Vera-loves-program/acg720-vision-robot/docs/六题演示与修复验收_20261025.md

# 六题演示与本轮修复（客户端 v20）

> **当前核心版优先：** 为解决888条未布通，LCD设置/PID/候选选择/速度编辑等已删除，六题主干不变；具体按钮和编译结果以[核心版说明](核心版编译与视频可行性_20261025.md)为准。用户已授权代理运行高云，新构建记录在`tmp/core-route-20261025/`；下文“未运行高云”和24页UI均为上一轮状态。

这是当前源码的操作说明，优先于旧版 ARM、三秒倒计时、自动后退和 v18 手动重启说明。**代码、离线回归已更新；尚未运行 Gowin、生成新位流或验收实车。** 用户目前充电、Pi 已关机，本轮没有操作设备。

## 先更新一次

FPGA：仍打开原来的 `vision_robot_ui.gprj`，由用户编译本轮源码并下载。工程/约束/厂商 IP 没有在本轮修改；目录已有 fs 不代表包含这轮改动。保留 FPGA 摄像头→DDR→LCD。

Pi：充好电开机后，先网线连接电脑。电脑 PowerShell：

```powershell
scp "D:\GOWIN_PROJECTS\acg720_vision_robot\output\releases\acg720-orangepi-v20-code.zip" orangepi@192.168.10.3:/home/orangepi/
ssh orangepi@192.168.10.3
```

以下在 Pi 的 SSH 终端执行：

```sh
cd /home/orangepi/acg720_vision
cp -a config/gimbal.json config/gimbal.before-v20.json
unzip -o /home/orangepi/acg720-orangepi-v20-code.zip -d /home/orangepi
/home/orangepi/.venvs/acg720-detection/bin/python -c "import json; print(json.load(open('manifest.json'))['client_bundle_version'])"
sh tools/install_orangepi_poweroff.sh --install
sh tools/install_fpga_follow_service.sh
```

版本应为 **20**。本次代码包不包含现场 `gimbal.json`、`visual_task.json` 或模型，不重装 Python/OpenCV。安装脚本会结束旧的真实 `usb_gimbal.py` 进程，再安装视觉开机服务；启动服务本身不选目标、不转舵机、不启动轮子。以后不用每次开机运行 nohup。sudo 可能要求输入密码。

以后更新代码后的重启与检查统一使用：

```sh
cd /home/orangepi/acg720_vision
sh tools/start_fpga_follow.sh --restart
sh tools/start_fpga_follow.sh --status
```

电脑有线 `.4`，Pi `.3`，FPGA `.2`，掩码 `/24`。确认服务正常后，把网线从电脑换到 FPGA。换线产生短时 `Network is unreachable` 不再变成永久 PWM 错误。服务/相机正常与 FPGA 链路正常是两个条件；LCD 的 `PI LINK WAIT` 明确表示后者尚未建立，不能用“进程存在”代替链路验收。

## 六个入口

| 首页 | 操作 | 本轮行为 |
|---|---|---|
|1 CAMERA + IMU|直接进入|FPGA 摄像头画面与 IMU 显示保留；与 Pi USB 相机独立。|
|2 MOTOR CONTROL|FORWARD / REVERSE / TURN LEFT / TURN RIGHT / TURN 180 / STOP|点击方向直接执行，不需要 ARM。SPEED 调速度。|
|3 LIDAR AVOID|START / STOP / VIEW MAP / RADAR +90|沿车头低速走，前方近障减速/停车。地图可见。**此页演示减速/停车；路线绕行在题4/6。**|
|4 XY NAVIGATION|HERE IS ZERO → SET GOAL → GO TO GOAL|一键当前位置为原点、当前车头为 +X、左侧为 +Y；X/Y 单位 mm。LEFT/RIGHT 90 独立陀螺仪转向。|
|5 VISION TARGET|TRACK DOG / CHOOSE OBJECT / STOP TRACK|自动选择连续稳定的小狗，或按实时稳定 ID 选择其他候选，云台居中，车轮不走。|
|6 FIND DOG|FIND DOG / FACE DOG / GO NEAR DOG / SIDE FOLLOW / CAMERA FRONT / STOP|搜索、雷达定位、转向目标及带避障的接近；原左侧前后跟随放在 SIDE FOLLOW。|

SETTINGS 是统一调试入口。ALL STOP 随时停止动作；无需另点 ARM。保留真实电机故障、传感器断流、近障停车及已确认舵机限位。导航错误后不会自动倒车，也不会在解除故障后自行续跑。

### 题4：坐标、90°和指定点

静止等陀螺仪校准完成。将车头朝你希望的 +X，按 **HERE IS ZERO**。实现先停止控制链，随后同时清 X/Y/航向和旧地图，不会只改屏幕数字。默认目标为 `(300,0)`。SET GOAL 只有 X−/X+/Y−/Y+/STEP/DONE；先验证 `(300,0)`，再 `(300,300)` 等点。

LEFT 90 应原地左转约90°，RIGHT 90 相反；使用实测 Z 轴角速度积分后的航向与零偏修正。固定角度转向不经过旧自动后退恢复，也不依赖轮子位置环。陀螺仪不是绝对罗盘，长时间漂移仍需静止重置；不能声称是完整 SLAM。

GOTO 在车体坐标控制前进、用航向外环旋转；遇阻时在**已知空闲**栅格内做车体膨胀后的路径规划，未扫描区不能冒充可通行。`START UNKNOWN` 表示起点周围没有足够扫描覆盖，`GOAL UNKNOWN` 表示目标附近覆盖不足；`START/GOAL BLOCKED` 才表示已有障碍证据。不要靠取消全部避障来掩盖朝向映射错误。

### 题6：小狗搜索和雷达接近

物品升到雷达扫描平面，物品附近空旷，途中允许有障碍。只靠相机方向与激光几何，无法识别“完全共线且遮住小狗的同尺寸物体”，所以不作这种保证。

1. 首次建立**相机车头方向参考**：先在题5 TRACK DOG，使车轮静止，把小狗放在车头正前方约1–2m，等云台居中。进入题6后如切页已清目标，按 FIND DOG 重新锁定；小狗仍在正前方时按 **CAMERA FRONT**。显示 `CAMERA FRONT SET`。它保存到独立 `config/visual_task.json`，不改 PWM/角度表或原图像运动采样。以后重新烧录、更改原点无需重教这个车身安装参考；改变相机安装、PAN方向或角度表后要重新教。
2. 按 **FIND DOG**：只在实测 PAN 角度/限位内扫描，等三帧稳定目标；一个方向找不到时请求 FPGA 原地左转90°再扫。最多四个朝向/三次转车、总180秒；转车无法在12秒内完成则结束，显示 `DOG NOT FOUND`。这也可能表示转向受阻，查看雷达页面。不会无限转圈。发现目标时停止搜索转车，再居中定位。
3. 等 **DOG POSITION SET**。FPGA 使用激光返回点估计目标位置；不会用框大小、PAN角或假定玩偶大小估距离。题6左侧 X/Y 是该扫描下相对轮轴原点的激光簇中心，单位 mm。云台 PWM 仍是命令估计，没有新增机械编码器。
4. **FACE DOG**：由 FPGA 对实际雷达簇 `atan2(Y,X)`，结合扫描时陀螺仪航向，原地面向目标后停下。
5. **GO NEAR DOG**：一次点击锁存目标世界坐标及接近点，用题4同一导航/栅格规划绕路。默认轮轴原点距目标的雷达表面 **512mm** 停车；不是车头边缘512mm，车头还向前伸出约231mm。这个距离兼容当前320mm量级的规划膨胀，避免目标本身把停车点封死。不会追撞物品。可在独立配置中调整 `standoff_mm`（350..1500），须结合地图分辨率和车体确认实际可达。
6. STOP/离开视觉页/断网会撤销运行授权；恢复网络后重新点击动作。已经开始的接近任务固定原目标，途中新出现的近障不会被改叫“小狗”。目标定位有歧义时不允许开始新的接近。

雷达关联：以车体坐标连续点间距100mm分簇；完整簇至少3点、X/Y跨度均不超过400mm；用相机方向筛选，唯一且连续两扫描稳定才确认。先分完整物理簇再筛方向，避免把大墙在方向锥内的片段假装成小狗。`LASER AMBIGUOUS` 时移开目标旁同方向物品；`WAIT LASER MATCH` 时检查小狗高度、雷达安装角及相机车头参考。

没有完整相机内参时，系统只在玩偶靠近画面中心时使用已标定云台的中心光轴，水平容差约7°，属于近似方向。PWM到实际机械位置的滞后、相机平移未知都会影响关联，不能宣称毫米级视觉外参。默认将相机原点不确定度设为261mm（车体范围），有实测时可在 `visual_task.json` 增加 `"camera_origin_mm":[X,Y]`，按轮轴原点 +X前/+Y左测量，降低误配。`pan_sign` 未指定时，CAMERA FRONT会优先从已经应用且角度表一致的原图像运动采样中提取PAN方向符号（要求水平响应占主导）；这只辨别方向，不把Jacobian当绝对姿态。无合格采样时默认 +1，沿用既有几何模型正角向左；实际正角相反时在独立配置明确设 −1 并重做 CAMERA FRONT。没有测量的外参不伪造为已标定值。

### 原左侧前后跟随

题6→SIDE FOLLOW：TRACK DOG；让小狗停在车左、云台居中，系统自动记录静止 PAN 参考；把小狗沿实际车头方向挪一点，等居中后 FRONT SAMPLE（PAN差至少3°）；START FOLLOW 直接开始。车只前后运动并保持航向，不改为追到车前方。默认视觉增益0.20、限速5 COUNT/10ms，FOLLOW SETUP可调。此模式根据教过方向的 PAN 偏差跟随，没有用 PAN 假算物距；雷达负责近障停车，**侧随本身不自动绕障**。

## 几何和上电参数

- O 是两驱动轮中心的中点；O 到前/后/左/右边缘为231.27/117.39/119/119mm。雷达 R 相对 O 为 `(32.56,-77.35)`mm。
- 从 R 到前/后/左/右边缘分别198.71/149.95/196.35/41.65mm。代码先把激光点转换到 O 再比较 O 的边缘，**不能把 R 的距离再次当车体边界扣除偏移**。整数实现保守取尺寸232/118/119/119、偏移33/−77。
- 行驶余量20mm、转向余量30mm、接触余量10mm；不是以雷达为圆心一律500mm禁止运动。转向仍考虑车头角扫过的范围。
- 当前雷达方向预置90°来自装配照片中三角标记朝车左的推断，**未实测确认**。如果正前方单一物品在地图显示成左/后/右，题3 RADAR +90 可循环修正；每次改角停止动作并清图。一键原点与雷达安装角是两个不同问题。
- 轮周204mm、编码器1469COUNT/圈、轮距213mm；速度 PID 上电30/1/0、最大PWM600‰，不用每次经 VOFA 恢复。位置环 P=0.125、I=D=0 是保守初值，尚未实车调定。

## 位置环到底做什么、怎么调

轮子位置环用于 **VOFA 的轮子“目标编码器位置”模式**：例如从0转到200COUNT，它以20Hz将剩余编码器误差换成速度目标，再由100Hz速度环执行；目标速度的绝对值同时是位置模式的速度上限。NAV 的世界 X/Y、90°转向、视觉跟随都通过现有速度环运行，不使用这两个轮子位置 PID，因此不是“位置P=0导致90°只倒车”。

两轮分别调，先 I=D=0、位置P=0.125、速度上限约3–5COUNT/10ms，发100–200COUNT的小阶跃。停得太慢且不超调时逐步增 P（如0.1875、0.25）；来回摆就减 P。先确认编码器正方向与电机正方向一致。只有确定存在持续静差且不是死区/摩擦问题再加很小 I；不要同时改速度环。实际 VOFA 命令沿用原协议，本轮没有改蓝牙串口。

## 关机和日志

POWER OFF PI 只请求 Pi 的 Linux 正常关机；失败显示权限/执行失败，可再点一次。FPGA继续运行 LCD 与本地题目，撤销原30秒全局软件停机。FPGA没有新增电源保持电路或软件断电功能，要真正断电仍用电源开关。Pi重开机后视觉服务自动启动，先在全部输出关闭的状态下完成新会话握手，清除上一轮目标/关机请求；无需为了重开Pi而给FPGA断电。新动作仍由LCD点击。

查日志（网线接电脑后在Pi SSH）：

```sh
sh /home/orangepi/acg720_vision/tools/start_fpga_follow.sh --status
tail -n 60 /home/orangepi/acg720_vision/follow-console.log
```

换网线后 SSH 断开正常；开机能登录并不能证明曾掉出的SD卡完全没有文件系统损伤。本轮没有对卡执行修复或文件系统写入测试。

## 验证范围与资料

离线检查执行真实 Pi 控制器配模拟 UDP/PWM、坐标/停车点/墙面拒绝/遮挡目标锁定的数值回归，以及 RTL 语法语义与接口检查。另附 `tests/tb_robot_visual_laser.v` 给后续 HDL 仿真使用。**没有执行动态 HDL 仿真、Gowin综合/布局布线、时序分析、Linux服务现场安装或实车测量**。验证记录见 `tmp/task-ui-fix-20261025/validation.json`。不能将旧版22组测试的历史结果套到新 UI；新版对应检查已更新。

资料依据：坐标遵循 [ROS REP-103](https://github.com/ros-infrastructure/rep/blob/master/rep-0103.rst)；相机方向与深度的区分及刚体外参参照 [OpenCV calib3d](https://docs.opencv.org/4.12.0/d9/d0c/group__calib3d.html)；独立转向后接路径跟踪的结构参考 [Nav2 Rotation Shim](https://docs.nav2.org/rolling/configuration_and_development/configuration_guide/controller_plugins/configuring_rotation_shim_controller/)。这些资料支持模型，不证明本车已完成外参标定或实车验收。
