Vera-loves-program/acg720-vision-robot/docs/扩展板规划.md

# 当前硬件接口与架构

原长篇早期产品设想、已淘汰接线和逐轮综合/布线追加记录已收进`archive/cleanup-20261025/documents-before.zip`中的同名文件。当前状态以根README、交接PROMPT和各联调说明为准。

## 1. 固定工程与职责

ACG720-60K / GW5AT-LV60PG484AC1/I0，原工程vision_robot_ui.gprj，顶层vision_robot_ui_top。源码默认ROBOT_MODE=1、ACTUATOR_TEST=0、SEND_CAMERA_UDP=0。

FPGA保留OV5640→DDR3→LCD、IMU、双电机编码器/速度PID、C1串口/地图/车体避障/导航、蓝牙VOFA和双BQ。Pi5 USB相机做玩偶/人脸、云台视觉、PAN前后跟随外环；新方案实际舵机PWM由FPGA输出。USB图像不进FPGA，LCD FOLLOW只选元数据目标。

新代码不需要添加gprj文件：FOLLOW控制和PWM模块追加在robot_subsystem.v中，沿用UDP32字节接收暂存。不要删摄像头、改厂商IP或放宽时钟约束来逃避资源/时序问题。

## 2. 当前实际接线

| 功能 | P7物理脚 | 说明 |
| --- | --- | --- |
| 板上IMU I²C | 1 SCL /2 SDA | A13/A14，姿态来自IMU，不把陀螺仪当平移速度计 |
| 蓝牙 | 14 FPGA TX /13 FPGA RX | B13/C13，115200/8N1，AAA经典SPP已在VOFA正常使用 |
| BQ A | 7 SCL /8 SDA | 独立开漏总线 |
| BQ B | 15 SCL /16 SDA | 独立开漏总线 |
| 左轮 | 18 AI1 /17 AI2 /20 PWMA | 方向与ENC SIGN分别标定 |
| 右轮 | 19 BI1 /22 BI2 /21 PWMB | 同上 |
| 编码器L/R | 23/26，25/28 | 默认左反相1、右0，以向前反馈正为准 |
| 云台PAN | 24 /D16 /servo_1 | 新方案从Pi物理16改接这里，1200μs启动参考 |
| 云台TILT | 27 /C18 /servo_0 | 从Pi物理15改接这里，2100μs参考 |
| C1串口 | 38 FPGA TX→C1 RX，40 FPGA RX←C1 TX | E18/F20，460800/8N1，3.3V逻辑，Standard A5 20 |

超声和旧激光/TOF不再用于当前避障，相关旧源可保留但顶层不启用。步进预留无当前任务，不要删改冻结引脚。舵机外部供电并共地；不能把Pi和FPGA两个信号输出并接。

## 3. 实测几何和电池

两驱动轴中点O，+X车头/+Y车左，A端车头、B端云台车尾。雷达测距核心R在O前32.56mm/右77.35mm，源码(+33,-77)。完整无突出部件外廓前231.27/后117.39/左右119mm，向外取232/118/119/119。行驶50、转向100、虚拟接触10mm；转向圆半径261+100=361mm。所有值可在LIDAR INSTALL在线改；ZERO还需车头纸板核验。

轮径65mm、周长204mm、轮距213mm、共用CPR1469（10圈L14683/R14690）。两轮速度P30/I1/D0、PWM60%是用户已调值，复位不保存，要用VOFA恢复。

两块12V标称18650/2800mAh电池。A83/B88映射为显示100%，单点映射不等于库仑容量/电压完整校准。A映射≤20%有效持续5秒请求Pi正常关机，也可LCD手动请求；30秒后FPGA只是输出锁定，不是电源切断。BQ板级设置曾基于240kΩ/16.5kΩ、3S、初始Divider15545；外部10k B3950温度曲线仍未完整校准。不要自动执行BQ SETUP、学习或改化学模型；旧DF审查和电压异常细节在历史原件第32～34节。

## 4. 当前联调入口与证据

先读《前四项任务联调》《导航避障与延时启动》《香橙派与FPGA跟随联调_20261025》。已有用户12:48新位流/报告，资源见README；是否对应最终源码、时序合格、已烧录与实测表现待确认。代理不自动运行高云或烧录。

`tmp/nav-envelope-20261025/`保留本轮保护哈希、模型/结构检查及前一版baseline.zip；`tmp/night-build-20261024/`保留此前成功/失败构建证据；`tmp/lidar-investigation-20261025/`保留C1手册抽取/关键页。旧findings的550mm分析已明确标历史。根交接PROMPT是后续AI入口，旧规划不再堆积构建状态。

## 28. P7冻结物理核对表

原理图核对用的网名和球位保持不变；38/40在下表保留原预留网名PIN38/PIN40，当前用途已分配C1，不再是可随便占用的空脚。

### 28.2 从最下排向上逐排对照（左偶数、右奇数）

| 左侧物理脚 | 新图实际网名 | 60K球位/性质 | 右侧物理脚 | 新图实际网名 | 60K球位/性质 |

| ---: | --- | --- | ---: | --- | --- |

| 2 | GYRO_SDA | A14，双向开漏 | 1 | GYRO_SCL | A13，双向开漏 |

| 4 | LASER_ADDR_1 | A16，SHUT输出 | 3 | LASER_ADDR_0 | A15，SHUT输出 |

| 6 | LASER_ADDR_3 | A19，SHUT输出 | 5 | LASER_ADDR_2 | A18，SHUT输出 |

| 8 | BQ_A_SDA | F14，双向开漏 | 7 | BQ_A_SCL | F13，双向开漏 |

| 10 | ECHO | E14，输入 | 9 | TRIG | E13，输出 |

| 12 | GND | 主板固定地，正确 | 11 | 5V | 主板VCC5V0，正确 |

| 14 | UART0_TX | B13，输出；已解除30脚同网 | 13 | UART0_RX | C13，输入 |

| 16 | BQ_B_SDA | D15，双向开漏 | 15 | BQ_B_SCL | D14，双向开漏 |

| 18 | AI1 | C15，AIN1输出 | 17 | AI2 | C14，AIN2输出 |

| 20 | PWMA | B16，PWM输出 | 19 | BI1 | B15，BIN1输出 |

| 22 | BI2 | C17，BIN2输出 | 21 | PWMB | D17，PWM输出 |

| 24 | SERVO_1 | D16，PWM输出 | 23 | ENCODER1_A | E16，输入 |

| 26 | ENCODER1_B | B18，输入 | 25 | ENCODER2_A | B17，输入 |

| 28 | ENCODER2_B | C19，输入；旧CST是蓝牙TX | 27 | SERVO_0 | C18，PWM输出 |

| 30 | GND | 主板固定GND，已正确 | 29 | 3V3 | 主板VCC3V3，正确 |

| 32 | NC | E17为GPIO，当前不连接 | 31 | STP_PE0 | F16，STEP输出；旧CST是蓝牙RX |

| 34 | DIR_PE0 | C20，DIR输出 | 33 | STP_PE1 | D20，STEP输出 |

| 36 | DIR_PE1 | D19，DIR输出 | 35 | PIN35 | E19，备用 |

| 38 | PIN38 | E18，备用 | 37 | PIN37 | F18，备用 |

| 40 | PIN40 | F20，备用 | 39 | PIN39 | F19，备用 |

### 28.3 使用此表的边界

30是固定GND，32/E17是NC；不能按旧蓝牙位于28/31的历史接法布线。当前蓝牙已经迁到14/13。BANK2需实际3.3V供电/逻辑条件，CST不会替你改变电源跳帽。Pin1方向按丝印确认，不能把观察面的镜像当引脚互换。

## 37. 4×4m八分区演示地图（2026-10-16设计稿）

### 37.1 用更多任务丰富地图，保留开放通行空间

用户已确认车身外廓约30×50cm，提出原四区布局过于简单。本稿改为**八个地面语义分区、七个停车任务点、一条双向闭合环路**；中央使用四个40cm纸箱拼成不对称L形固定地标。彩色块用地垫/胶带标示，不能围成八个小房间，也不把区域道具摆进通行带。分区增加的是任务内容，不等于每区都增加实体障碍。

最新可缩放布置图：[arena_4x4.svg](assets/arena_4x4.svg)。此前visualizations目录的`arena-navigation-plan.html/png`与`arena-map-proposal.json`是四区初稿，未同步为八区；本节坐标与新SVG为本次设计依据。两者都是规划工具，**不是已实现的实车导航或正式赛场规则**。

本次重新核对[高云2026官方赛题](https://www.gowinsemi.com.cn/university/match2026)：选题三包含闭环运动、减速/停车/绕障、起终点与路径点导航，拓展包含视觉任务及语义导航；页面未规定4×4m、固定分区数量或必须在线SLAM。4×4m和下述布局是本队自定演示方案，不能写成官方强制要求。

### 37.2 坐标、分区和可演示动作

单位为米，原点在围挡左下**内边界**；+X向右，+Y向上；航向0°沿+X，90°沿+Y。目标坐标暂按车体几何中心定义，真正控制时须统一到驱动轴中点，并实测雷达安装偏移和车体突出部分。目标朝向为演示建议，未测到达误差。

| 分区 | 地面范围：X / Y | 停车目标 / 建议朝向 | 到达后动作 |

| --- | --- | --- | --- |

| A 待机/补给 | 0.10～1.20 / 0.10～1.20 | (0.65,0.65) / 0° | 固定起点、等待任务；仅模拟充电，不预设自动充电硬件 |

| B 学习提醒 | 0.10～1.20 / 1.45～2.55 | (0.65,2.00) / 180° | 到达后展示学习提醒；需要人物的演示可使用图像/玩偶 |

| C 阅读陪伴 | 0.10～1.20 / 2.80～3.90 | (0.65,3.35) / 90° | 定点交互，展示计时或语音陪伴 |

| D 资料领取 | 1.45～2.55 / 2.80～3.90 | (2.00,3.35) / 90° | 视觉确认标志物；人工放置物品，不预设抓取机构 |

| E 目标搜索 | 2.80～3.90 / 2.80～3.90 | (3.35,3.35) / 90° | 停车转云台，确认现有模型支持的目标 |

| F 休息互动 | 2.80～3.90 / 1.45～2.55 | (3.35,2.00) / 0° | 到点停车，展示互动/休息提示 |

| G 物品送达 | 2.80～3.90 / 0.10～1.20 | (3.35,0.65) / 0° | 送达提示，人工取物 |

| H 动态绕障 | 1.45～2.55 / 0.10～1.20 | 通行测试区；阻塞时不设强制到达点 | 放入临时纸箱，验证减速、停车、绕另一侧环路 |

道具优先贴在围挡或放在围挡外侧；如果放进场内，则其真实外廓必须加入静态占据图并重新检查路线。“学习区”到达后使用哪一个动作，由任务表保存；雷达不需要读懂地垫上的文字或颜色。

中央固定纸箱：三个40×40cm箱沿X相邻排列，底面依次为`[1.40,1.60,1.80,2.00]`、`[1.80,1.60,2.20,2.00]`、`[2.20,1.60,2.60,2.00]`；第四个为`[2.20,2.00,2.60,2.40]`。数组顺序均为`[xmin,ymin,xmax,ymax]`。固定后测量实际箱体外沿录图，不依赖商品标称尺寸。围挡/箱体必须穿过实际雷达扫描平面，且留出安装倾斜余量；地面胶带不是2D雷达可见的墙。中央不对称L形用来减少四面正方形造成的方位混淆，不能据此保证任意初始姿态都可可靠重定位。

### 37.3 通行和旋转的几何检查

静态候选中心线依次为`A—B—C—D—E—F—G—H—A`，其中无障碍时H仅为南侧中心线中间位置`(2.00,0.65)`。东西通行带真实宽度为1.40m，南北分别至少1.60m；语义地垫本身不减少净空。实体布置新增窄口时，建议起步不小于0.80m，并单独复核转弯。

30×50cm矩形围绕几何中心原地旋转的最远角点半径为`√(0.15²+0.25²)=0.29155m`。本稿额外给出0.10m物理净空、0.10m定位误差预算，保守按圆形膨胀半径`r=0.49155m`检查。**0.10m定位余量是设计假设，不是实车已达到的定位精度。** 驱动轴不在几何中心、线缆/轮胎/云台突出、轮子打滑或误差大于预算时，须增大包络重新验算。

独立Python几何计算检查了八条轴对齐中心线到围挡及固定箱体的最短距离，全部通过；最小原始距离为0.65m，减去上述包络后尚余0.15845m。该圆包络包含0～359°逐度旋转的矩形四角，因此覆盖图中停车点原地转向的名义几何扫掠。它不证明定位、制动或控制已经实现，动态停车距离仍应实测，不能让软件一直顶着箱体试转。

临时40×40cm箱放在`[1.80,0.45,2.20,0.85]`，占住H区中心线。相同检查得到仅`A—H`、`H—G`被阻塞，其余绕行边仍通行：

- 无临时障碍：`A→G`南侧直达，中心线2.70m。

- 有临时障碍：`A→B→C→D→E→F→G`，中心线8.10m。任务点可选择仅经过，不必每点都执行任务。

- 若正在行驶后才放箱，应先减速/停车并确认重规划，再选择替代边；未确认自由的空间不能仅凭“地图上应当没有箱子”继续前进。

- 人员或箱体封住另一侧、剩余通道不足时，正确行为是停车并报告暂时不可达。

### 37.4 地图如何存在FPGA里，以及怎样逐步完成

至少保存三类数据：**几何地图**表示哪儿有围挡/箱体，**语义任务表**表示某个区域叫什么、目标坐标/朝向及到达后动作，**动态观测**表示现在新增了什么障碍。它们可以叠在同一张图显示，但来源和更新方式不同。2D雷达在其高度平面测到墙和箱体，编码器/IMU估计车移动了多少；将观测与已知几何匹配才是在修正自己的位置。地面地图图像只是数据表示，存入PNG或像素本身不会产生定位能力。

本稿先用已量好的围挡/纸箱尺寸生成静态地图，不把“在线SLAM、自动探索未知地图”作为11月4日前导航的前置条件。5cm栅格为80×80=6400格，2bit/格的静态状态仅1600字节；雷达扫描缓存、定位搜索、路径规划工作数组及日志另算，不能只用这1600字节宣称算法已放得下。语义区可用八条矩形范围和任务记录保存，无须给每格存汉字。

建议按能独立演示的顺序实现：

1. **几何与运动标定**：测轮径、轮距、编码器分辨率和轴/雷达偏移；先完成左右轮速度闭环及低速停车。

2. **固定起点路径点**：人工摆正A点，编码器增量+IMU航向估计位姿；先走A到G短线、再走整圈，记录误差。开环按时间转弯不能代替定位。

3. **雷达接收与保护停车**：检查帧/距离有效性，计算前方障碍区；数据超时/无有效量测时采用明确的降速或停车策略。近距离或扫描平面外障碍由已有TOF/超声补充，具体覆盖需实测。

4. **已知地图定位校正**：利用四周边界和中央L形对编码器/IMU预测位姿做小范围匹配，逐步加入方向/距离修正。初版固定A点起步，暂不要求任意搬动后全局自动恢复。

5. **动态绕障与语义任务**：先做八节点路网的边阻塞与绕环重规划，再从名字查坐标，到达后调用视觉/交互功能；全场栅格A*、更自由的局部绕行可在稳定后扩展。

以上只是实施计划，没有新增导航RTL、启动HDL编译/仿真或给实车下发运动命令。本节产物是坐标/净空方案、静态几何检查和SVG布局。

### 37.5 厂商印刷用纯地图（2026-10-20）

厂商使用[4000×4000mm原尺寸矢量PDF](../output/pdf/arena_4x4_print.pdf)，[PNG仅供预览](../output/pdf/arena_4x4_preview.png)。打印版保留原八区位置，去掉说明栏、标题、路线、箭头和动态纸箱，仅保留浅彩分区、名称/字母、细网格、四边米制刻度及四角坐标。10cm一小格/短刻度、50cm数字刻度，A～G小十字为原目标点，中央淡虚线为四个40cm固定纸箱的放置轮廓；这些图案不代替实体障碍。

PDF页面本身为4000×4000mm，中文字体已嵌入，采用CMYK矢量图形。交厂商说明：成品有效地图4000×4000mm，按原尺寸100%输出，不拉伸、不自动适配页面；包边/出血若需要，放在有效地图之外。围挡内侧对齐地图外沿，不能压进有效范围缩小场地。印后实测相邻1m刻度距离。推荐浅彩色便于观众辨认；黑白也可通过字母和名称区分，对2D雷达定位没有颜色上的收益。
