Vera-loves-program/acg720-vision-robot/docs/视觉雷达协议_v20.md

# v20 视觉、雷达与任务协议

当前运行操作见《六题演示与修复验收_20261025.md》。v20 代码包与本轮 FPGA 源码配套。UDP路径、32字节包长度与原 held-data/ACK 接收跨时钟机制不变；没有图片/地图传输。Pi→FPGA `.255:5001`，FPGA→Pi `.3:6102`，FPGA源`.2:5000`。

Pi→FPGA 的 DET1/FOL1/TGT1/VEC1/GOL1 都是大端，0..3 magic、4版本1、5 flags、6..7 u16序号、8..29正文、30..31 CRC16-CCITT，初FFFF、多项式1021。不同类型独立序号，模65536的前进窗口为1..32767；2秒断流后允许重新建立序号。数据内容不直接授权轮子运动。

## 原包扩展

FOL1 的原速度、PWM/限位、图像年龄、置信度、事件ACK和目标ID布局不变。bit7新定义为**新会话清理握手**，只允许其他flags全0、速度0、目标ID0时使用；清旧目标/关机请求及本次视觉运动授权，PWM保持关闭。Pi新进程先基线化收到的旧LCD事件，不重放它，再重复清理请求直到回报 op=0/ID=0/关机请求=0。Pi重启不需要FPGA断电。bit0..6仍分别为目标有效、已参考、已教前进方向、PAN开、TILT开、已接受关机、错误。

TGT1 原四个候选槽（8..23，每槽IDu16/类别u8/置信度u8）保留；连续3帧、分数≥0.50才入列表，按稳定ID实时更新。24..29：`A1`标识、诊断码、最高狗分数%、最高人脸分数%、图像年龄u16。只在RBT能力bit7置位时发送扩展，否则六字节0兼容旧FPGA。诊断32搜索、33搜索转向、34未找到、35已记车头、36需记车头、37雷达歧义、38等待匹配、39已定位。

## VEC1：Pi云台方向查询（20Hz）

flags bit0视觉方向有效，bit1有限搜索请求一次车身左转90°。其余0。

|偏移|字段|
|---|---|
|8..9|目标ID u16；搜索未找到时可为0|
|10..11|原始图像年龄ms u16；无有效方向为65535|
|12..13、14..15|车身水平单位方向dx/dy，signed Q14|
|16..17、18..19|相机原点相对轮轴O的X/Y，s16 mm；未知时为0并配大不确定度|
|20..21|方向锥tan半角 Q14，供日志；当前RTL固定1/8（约7.125°）以免宽乘法|
|22..23|车身方向角，s16，0.01°；用于扫描间方向稳定检验，不冒充距离|
|24..25|相机原点横向不确定度mm u16；未知261、已测25|
|26..29|保留0|

方向来自图像到达时云台估计角与车头安装参考。没有相机内参时只用居中目标光轴，不推测焦距或物距。FPGA在扫描开始冻结查询/车体姿态，按连续完整雷达簇筛选；2次稳定匹配后有效。车轮速度超过2COUNT/10ms、扫描期间位移≥20mm、航向变化≥2°或视觉方向变化≥2°时本扫描不定位。

搜索转向只在本地LCD FIND DOG已授权、链路/陀螺仪/雷达有效、转向范围空闲时执行。一个bit1请求只执行一次；实际导航TURN完成脉冲锁存RBT bit6，Pi收到后清请求，FPGA再清完成位。STOP、离页、掉线撤销；检测到目标后清请求也会停止搜索转车。

## LDR1：FPGA已匹配激光观测（10Hz）

FPGA状态包末字节为前31字节异或，不用CRC16。与RBT1在TX邮箱捕获时交替发，总20Hz，各10Hz；不能用另一个自由运行时钟切换包类型再低频采样。

|偏移|字段|
|---|---|
|0..3、4|LDR1、版本1|
|5|bit0唯一稳定激光匹配有效|
|6..7|扫描序号u16|
|8..11、12..15|扫描开始时轮轴O世界X/Y，s32 mm|
|16..19|同一时刻陀螺仪航向，s32毫度|
|20..21、22..23|匹配簇包围盒中点相对O的X/Y，s16 mm；测得的表面点，非玩偶几何中心|
|24..25|所关联视觉ID u16|
|26、27|候选簇数、该簇激光点数u8（饱和255）|
|28..29|本次结果年龄ms u16|
|30|状态：0等待、1未匹配、2歧义/过宽、3待第二次稳定、4有效、5运动/姿态/方向变化|
|31|前31字节异或|

FPGA另以串行CORDIC计算激光簇 `atan2(Y,X)` 加扫描航向，作为FACE DOG的世界目标航向。Pi把同一个包中的bodyXY与扫描pose旋转平移得到世界目标，不能用较晚RBT角度替换包内角度。体内激光点不作为外物，O/R外参只转换一次。

## GOL1：Pi停车点建议（20Hz，仅有新鲜唯一匹配时）

|偏移|字段|
|---|---|
|8..9、10..11|目标ID、观测年龄u16|
|12..15、16..19|建议停车点世界X/Y，s32 mm|
|20..23、24..27|已锁定目标世界X/Y，s32 mm|
|28..29|O到目标表面停车距离u16 mm，默认512，范围350..1500|

Pi第一次唯一匹配后锁定静止玩偶世界点；后来的激光点偏移超过150mm视为不一致，不换成新目标。目标变更/STOP清锁。停车点为 `target - standoff * unit(target-observer)`，已经在停车距离以内则建议当前位置。目标/停车点都限定在地图范围内。

FPGA仅缓存建议；必须本地LCD GO NEAR DOG、新鲜目标/激光匹配、事件ACK及运动条件同时成立才开始，点击时锁存停车点，经同一个robot_mission_control走已知空闲地图路径。途中保持原目标，不自动把每一帧建议当成新的运动命令。GOTO途中的路径点DONE不等于最终到达；TURN用真实TURN完成脉冲结束。

## RBT1：10Hz

原32字节布局保留：5flags，6..7 LCD事件序号，8 op，9..10 ID，11增益，12..13限速，14..17航向毫度，18..21已应用PAN/TILT PWM，22..23 FOL序号，24..27两轮速度，28..29 TGT序号，30导航状态，31异或。

flags：0视觉运动授权、1旧倒计时兼容、2链路有效、3已选ID、4Pi关机请求、5激光关联有效、6搜索转向完成、7扩展能力。op：0无，1选ID，2旧参考兼容，3教侧随前进方向，4清目标/关云台，5自动选狗并跟踪，6仅Pi关机，7有限搜索狗，8记录相机车头参考。

Pi按新事件去重。关机失败可以点按钮产生新事件重试，同一失败事件不会每个包重复调用sudo。FPGA无30秒关机锁，不会因Pi关机停止本地LCD/题目。新Pi会话仅关闭所有输出后清旧关机锁。字节校验、数据新鲜、软件返回成功都不能当成物理舵机角度或整车验收。
