Vera-loves-program/acg720-vision-robot/docs/README.md

# 文档入口

现场操作只需下面三份：

1. [当前交付和Pi更新命令](../output/releases/README.md)
2. [直线导航、实时避障、VOFA命令](直线导航与人脸联调_v22.md)
3. [人脸/小狗跟踪与135°云台测试](香橙派v22人脸与小狗测试.md)

[R7编译结果](R7编译结果与更新_20261025.md)包含资源、时序限制与验证范围。其余协议、教学、选型等文件供查资料。旧版操作说明仅保留在原开发机的`archive/`，不上传GitHub，也不用于操作当前版本。
