Vera-loves-program/acg720-vision-robot/docs/FPGA视觉跟随通信协议_20261025.md

# 当前视觉协议入口

客户端v20与本轮FPGA源码请读[视觉雷达协议v20](视觉雷达协议_v20.md)。包含FOL1/TGT1兼容扩展、VEC1/GOL1/LDR1、扫描姿态、仅Pi关机/新会话握手和本地运动授权。

原v18协议的“保留位全0、冻结候选列表、0.65门槛、倒计时、30秒全局软件停机”不再描述当前源码。
