Vera-loves-program/acg720-vision-robot/docs/R7编译结果与更新_20261025.md

# R7：布线恢复与更新文件

2026-10-25 21:36:26，Gowin 1.9.11.03完成综合、布局布线和位流生成，耗时537.4秒，错误0。此前R6的656条未布通网络已不再出现。原工程、CST、SDC、三份流程配置及厂商IP未改；构建使用相同配置的隔离工程，只在临时SDC追加三个定向时序报告命令。

## 新候选与更新

- FPGA：本机`output/releases/vision_robot_core_r7_2136_NOT_TIMING_CLOSED.fs`
- Pi：本机`output/releases/acg720-orangepi-v22-code.zip`，可通过打包器重新生成
- [构建及哈希记录](../output/releases/records/vision_robot_core_r7_2136.json)随仓库保留；构建证据和冻结RTL源码ZIP仅存原开发机`output/releases/records/`。

位流、更新ZIP和临时报告不在Git中。新成员克隆后按根README编译/打包；以上历史构建状态不自动代表其自行生成的位流。

FPGA文件SHA256：`6b568daa36a80b907aa6e48d988d23549b63fb84282c45bbc5659654c091c99a`。

**Programmer中可手动选择上述R7文件。** R7在独立目录编译，不会同步原工程窗口的完成状态；21:36时原`impl/pnr`仍是19:12旧输出。用户21:49已另行启动原工程编译，该轮结果以其最新日志和生成时间为准。整理未接触活动`impl`。本轮没有自动烧录、连接串口、启动底盘或操作Pi。

Pi必须另行更新到v22；只烧FPGA不会改变当前Pi v20的2100启动参数。完整步骤见[Pi更新说明](香橙派v22人脸与小狗测试.md)。包不覆盖现场标定、车头参考或模型。

## 布线优化实际结果

| 布线后资源 | 失败R6 | R7 |
| --- | ---: | ---: |
| Logic | 39690 | 38248 |
| LUT | 32501 | 31364 |
| 寄存器 | 22137 | 19853 |
| CLS | 25453 | 24970 |
| BSRAM | 60 | 60 |
| DSP | 9.5 | 7.5 |

主要改动：机器人配置下移除未使用的网络DET显示链和重复报文缓冲；六轴IMU改成逐字节格式化、双缓冲RAM显示；地图完成事件改用同域脉冲，删掉重复宽计数比较；本地相机绕过可选高斯滤波。OV5640→DDR3→LCD、原缩放链、六轴数据显示、导航、雷达、Pi跟踪元数据和VOFA均保留。没有新增Pi视频或新的手势功能。

## 时序边界

| 时钟 | 要求MHz | Fmax MHz | 定向setup最差裕量 |
| --- | ---: | ---: | ---: |
| 控制clk50M | 50 | 50.034 | +0.014ns |
| 网络接收 | 125 | 125.559 | +0.036ns |
| LCD | 45 | 50.921 | +2.584ns |
| 网络发送 | 125 | 125.000 | 未追加专用路径报告 |

七个时钟的同域setup/hold负裕量统计均为0。但**完整时序尚未闭合**：报告仍有1270个setup、21个hold违例端点，另有复位recovery违例。21个hold都是跨时钟的同步器/FIFO/厂商复位路径，最差−0.534ns；最差recovery为50MHz的`ready`到LCD域异步CLEAR，−7.309ns。没有逐项完成全部跨时钟setup审核，不能将这些违例一概称为误报。

50MHz/网络接收裕量很薄，发送Fmax四舍五入后恰好125MHz；PRIMARY和LW仍各8/8。因此这是**已布通、尚未完整时序验收的测试候选**，不是所有硬件问题均已解决的证明。

## 配套功能与验证

功能详见[直线导航与人脸联调](直线导航与人脸联调_v22.md)：固定直线段、对称航向纠偏、5mm最终坐标判定及1°最终对齐、转向上限12、实时地图重规划、优先右绕；遇障仍保持扫描和目标，新地图确认可行后续走，STOP取消任务。题5可选人脸/小狗，题6默认寻找人脸；Pi v22准备姿态后再跟踪，按实测角度表请求135°并限制不低于90°。

27组离线模型、源码契约、事务及模拟对象检查全部通过，记录见`tmp/core-route-20261025/r7-offline-validation.json`。包括直线/转向数学、等待与续走、地图边界、UDP字节连续接收、IMU全输入格式、人脸独立跟踪和舵机工作范围。**未进行动态HDL仿真或实车验证**，软件5mm容差不代表已测得5mm绝对定位精度。
