Vera-loves-program/acg720-vision-robot/docs/核心版编译与视频可行性_20261025.md

# 核心版、布线结果与视频后续

> 最新为21:36完成的R7，已恢复布线成功，原摄像头与六轴IMU保留。完整时序尚未闭合，当前文件/资源/违例边界见[R7编译结果](R7编译结果与更新_20261025.md)。本页后面的R1至R4状态为历史，不要据此选择旧位流。

本轮用户在 PR0004 / 888 unrouted nets 之后，明确授权代理精简并直接运行高云编译。只运行综合/布局布线，不烧录、不运行小车。工程、CST/SDC、三份process_config及厂商IP不主动改写。

## 为什么需要删减

17:13:18 的失败报告：Logic50921/59904（85%）、CLS28086/29952（94%）、RAM70/118（60%）。布线失败不能仅凭LUT尚有余量排除资源拥挤。失败证据、源码备份和本轮各次构建日志在 `tmp/core-route-20261025/`，不再把旧fs当新编译成功。

本轮首次精简综合：LUT42861→29629，ALU7642→6274，寄存器26462→20710。最终资源和时序以最新构建JSON/高云报告为准，综合数字不代替布线结果。

## 保留什么、删掉什么

**构建实测更新：** R1于17:41完成，R2于17:58完成，R3于18:52完成，均布通并生成位流，但均未满足全部原时序约束。R3总耗时656.8秒，Logic38565/59904（65%）、FF21515/60780（36%）、CLS25316/29952（85%）、BSRAM60/118。clk50M44.585<50MHz、GMII96.560<125MHz；LCD45.086≥45MHz、网络TX127.429≥125MHz。不得把exit0、生成fs或全部网络布通表述为时序通过。R3固定候选文件为`archive/cleanup-20261025-evening/old-releases/vision_robot_core_r3_1852_NOT_TIMING_CLOSED.fs`，完整证据为`tmp/core-route-20261025/build-184139.json`，包括源码哈希、生成位流哈希和各时钟结果。

保留六题首页、FPGA摄像头/IMU、直接前后/转向、固定角度陀螺仪转向、一键原点与车头+X、XY目标输入、雷达实时地图/避障/路径规划、小狗识别与云台跟踪、原左侧前后侧随、有限搜索和雷达接近、仅Pi关机。保留VOFA四条速度曲线和原调参协议。

24个界面精简到10个：六题本身加地图、XY目标输入和侧随页。删除LCD PID看板、候选ID翻页、编码器/轮距/外廓/增益等调试编辑器、测速报表、RTC数码管展示、电池DF配置/审计电路、未开启网络视频时仍残留的发送FIFO。电池电压/SOC读取与低电Pi关机条件保留，启动时不会重新写电量计Flash。

轮周204、编码器1469、轮距213、O到前/后/左/右232/118/119/119、R=(33,-77)mm固定为此前实测的整数值。速度PID上电30/1/0、位置P0.125/I=D0沿用；原蓝牙VOFA仍可调PID。固定参数后，原来许多跨模块编辑总线和运算多路选择器才能被综合删除。雷达朝向仍保留 RADAR+90，当前90°是装配照片推断，必须现场核对。

状态只显示当前任务、一个主要状态和最多六个必要值；所有数值共用20位串行十进制转换器。地图仍128×128、每格64mm，显示改为每格2像素，保留位置与朝向箭头，删除像素路径上的除3及旋转车体装饰；这不改变规划使用的实际车体外廓。

激光方向筛选四路乘法改为共用一路17×16乘法器，6拍完成一个点。C1两点间隔足够，发生真正超载时整扫描失效，不丢掉障碍点假装空闲。向量CORDIC32位缩为26位，角度和世界位置仍32位；60,000组乘法、50,081组向量逐拍等价检查通过。FPGA和Pi之间协议兼容v20，已部署v20时无需仅因精简LCD重复重装Pi。

## 核心版操作变化

R4于19:12完成，645.9秒。只做VOFA核心数据常值选择、UI/跟随故障通知一拍寄存、CCITT CRC并行异或等价优化；原始电机故障仍直接关闭桥。虽然再次布通，仍未时序闭合：clk50M44.922、GMII97.626、LCD44.822、TX122.025MHz。固定候选`archive/cleanup-20261025-evening/old-releases/vision_robot_core_r4_1912_NOT_TIMING_CLOSED.fs`，证据`tmp/core-route-20261025/build-190122.json`。本轮未加入Pi视频或手势，不能把它们算作已实现。

- 首页六题直接进入，仍没有ARM。
- 题2方向即走，180°与STOP保留；LCD不再提供速度编辑器。
- 题3 START/STOP/VIEW MAP/RADAR+90；地图页只BACK/CLEAR MAP。
- 题4 LEFT90/RIGHT90/HERE IS ZERO/GO TO GOAL/SET GOAL/STOP；XY步长10/100/500mm，目标限制在±3900mm。
- 题5 TRACK DOG/STOP TRACK/POWER OFF PI，直接自动选择稳定小狗；不再翻目标ID。
- 题6 FIND DOG/FACE DOG/GO NEAR DOG/SIDE FOLLOW/CAMERA FRONT/STOP；Pi关机独立按钮。侧随只TRACK DOG/FRONT SAMPLE/START FOLLOW/STOP，增益固定0.20、速度上限5COUNT/10ms。
- HOME/BACK/ALL STOP保留；CLEAR STOP只用于解除总停止锁，之后仍需重新点动作，不自动续跑。雷达在停止后继续扫描，方便查看阻挡原因。

Pi原有更新/服务/车头参考步骤见《六题演示与修复验收_20261025.md》；其中旧SETTINGS、PID界面、CHOOSE OBJECT、FOLLOW SETUP和SPEED按钮已移除，本文件优先。

## 香橙派摄像头显示能否加入

**可行，但本次精简构建不加入，不能先假定它一定能布通。** 推荐Pi负责缩放/画识别框，将RGB565分包发出，FPGA只做帧接收与显示。400×240、10fps的纯像素负载为15.36Mb/s；800×480、10fps为61.44Mb/s，均未含网络头。实际吞吐、CPU负载和丢帧需实测。直接拿网页JPEG流给当前FPGA并不能显示，现有RTL没有JPEG解码器。

当前DDR只有一个写入口，硬接camera_pclk和本地摄像头数据。新增Pi来源不能把GMII时钟直接用普通逻辑MUX切成camera_pclk；需要异步FIFO到共同入口时钟、完整帧编号/偏移/丢包处理、帧边界切换，并继续独立优先处理停止/跟随元数据。图像存外部DDR，不宜把整帧塞入BSRAM。没有同时显示两幅图的必要，可共用显示缓冲与缩放器，但是否需要双缓冲及仲裁还要按实际吞吐验证。

仅在题1启用本地采集，可以减少采集/DDR写入活动；电路仍在FPGA中，因此不会凭运行时关相机释放LUT/CLS。当前8/8主时钟资源也已使用，方案应共用现有时钟，不能随便再添PLL/时钟域。

## 四倍、按手指位置缩放

`lcd_camera_zoom.v`已经有Q8步长256..64（1～4倍）及两行缓冲。`touch_gestures.v`已有以双指中点为源图锚点的捏合算法，机器人模式因输入被取消而不可用；双击分支仍有重置到中心的旧行为，恢复时也要修改。

正确锚定方式：先记录 `源图锚点=旧裁剪起点+屏幕手指位置×旧采样步长`；改变倍数后 `新裁剪起点=源图锚点−屏幕手指位置×新采样步长`，再按图像边缘限幅。双指用中点，单指拖动应移动裁剪窗口。不能每次把裁剪窗口强制放到画面中心。Pi画面接入后应复用同一缩放链路，图片与识别框一起缩放；手势ROI仍须避开运动/停止按钮。

本轮保留这些缩放源码，但没有把未验证的新视频/手势功能混入核心构建。后续应在主干布通及关键时序确认后，单独实现与验收。

协议资料：[IETF RFC8085](https://www.rfc-editor.org/rfc/rfc8085.html)说明UDP应用需自行处理数据可靠性、包大小与发送节奏；[OpenCV颜色转换](https://docs.opencv.org/4.13.0/d8/d01/group__imgproc__color__conversions.html)提供BGR与565转换。这里只据此提出后续架构，没有在本轮实现视频接收。
