Vera-loves-program/acg720-vision-robot/docs/激光雷达选型.md

# 雷达选型已完成：思岚RPLIDAR C1

用户已经购买并安装C1，且已确认成功扫描，不再重新推荐LD19或重复选型。当前任务是安装方向、车体外参、地图/导航与实车验收。

- 当前操作：《雷达安装与导航阻挡排查_20261025》《导航避障与延时启动_20261025》。
- 工程串口：P7-38 FPGA TX→C1 RX，P7-40 FPGA RX←C1 TX，460800/8N1/3.3V逻辑。
- 厂商原资料仍在用户给定的`D:/BaiduNetdiskDownload/C1`，本次清理未修改；近期抽取/图页在工程tmp/lidar-investigation-20261025。
- 多站点评、其他型号比较和当时购买建议保存在`archive/cleanup-20261025/documents-before.zip`内同名原件。需要复盘选型时再查，不作为当前接线/驱动说明。
