Vera-loves-program/acg720-vision-robot/docs/视觉模型与数据检查.md

# 当前视觉模型、采集与误报边界

旧训练路线、R4/R5 UDP收图与历史模型评估原件在`archive/cleanup-20261025/documents-before.zip`。当前用USB相机，不恢复FPGA向Pi发图的旧流程。

## 已有事实

- 用户确认良好光照下玩偶和人脸可检测，静止小车的云台跟踪效果很好；本次不重新标注/重训，后续再加强误报。
- Pi5现有Python venv和OpenCV4.5.4沿用。玩偶模型`models/dog_plush/dog_plush_best.onnx`；人脸YuNet`models/face_yunet/face_detection_yunet_2026may.onnx`。当前CPU推理，不把RK3588 NPU部署说成已完成。
- human是人脸检测，不是身份识别；置信分数不是统计准确率。杂物/背景误判玩偶仍可能发生。

## 当前过滤和跟踪

v18候选需≥0.65且连续3帧，轨迹ID仅临时关联。LCD选择后保留类别，现有TargetTracker按位置/大小/姿态补偿及歧义判定关联，3帧稳定重现才恢复，不简单抢最高分框。最后一次真实观测只生成一次有限居中目标，不在丢帧时重复积分旧偏差；不是预测目标离开后怎样移动。

Pi→FPGA只发目标/PWM/速度元数据，实际车轮跟随和关机待实车验收。第一版是玩偶在车左、车沿前后跟随；20cm为初始相机距离，不宣称PAN角能直接算出真实距离或绝对世界位置。

## 拍照和下一次训练

网页“有目标·连拍10张”“背景·连拍10张”保存新原图，不带框和文字；目录`/home/orangepi/acg720_vision/dataset/usb_captures/positive/`与`negative/`。棋盘格用于镜头内参，与采集玩偶训练图不同，没有棋盘格不妨碍当前采集或已调好的云台跟踪。

后续重训应加入新相机/不同光照/角度/距离的正样本，以及容易误判的背景负样本；按完整拍摄场景划分训练/验证，避免相邻连拍帧跨集合造成虚高。标注类别与现有模型定义保持一致，再验证ONNX输入/输出和预处理，不随意换模型格式或假定NPU已适配。

运行、上传、照片/日志SCP与标定保留方式见《香橙派使用说明》和《香橙派与FPGA跟随联调_20261025》。历史训练细节需要时从归档查找，不先重装工作正常的环境。
