Vera-loves-program/acg720-vision-robot/docs/香橙派与FPGA跟随联调_20261025.md

# 香橙派与FPGA联调：v20入口

请使用[六题演示、更新与验收](六题演示与修复验收_20261025.md)。这里不再保留旧v18的杀父进程/三秒倒计时/自动后退操作，以免重复误操作。

当前支持原左侧前后跟随，以及云台搜索、雷达测距、面向目标和地图绕障接近。代码包位于工程内 `archive/cleanup-20261025-evening/old-releases/acg720-orangepi-v20-code.zip`，现场模型与标定不打包。协议见[视觉雷达协议v20](视觉雷达协议_v20.md)。

这些功能已做代码与离线检查，待用户编译FPGA并上板验证；没有新生成位流或替用户启动设备。
