Vera-loves-program/acg720-vision-robot/docs/bq34z100-g1_3s_reference.png

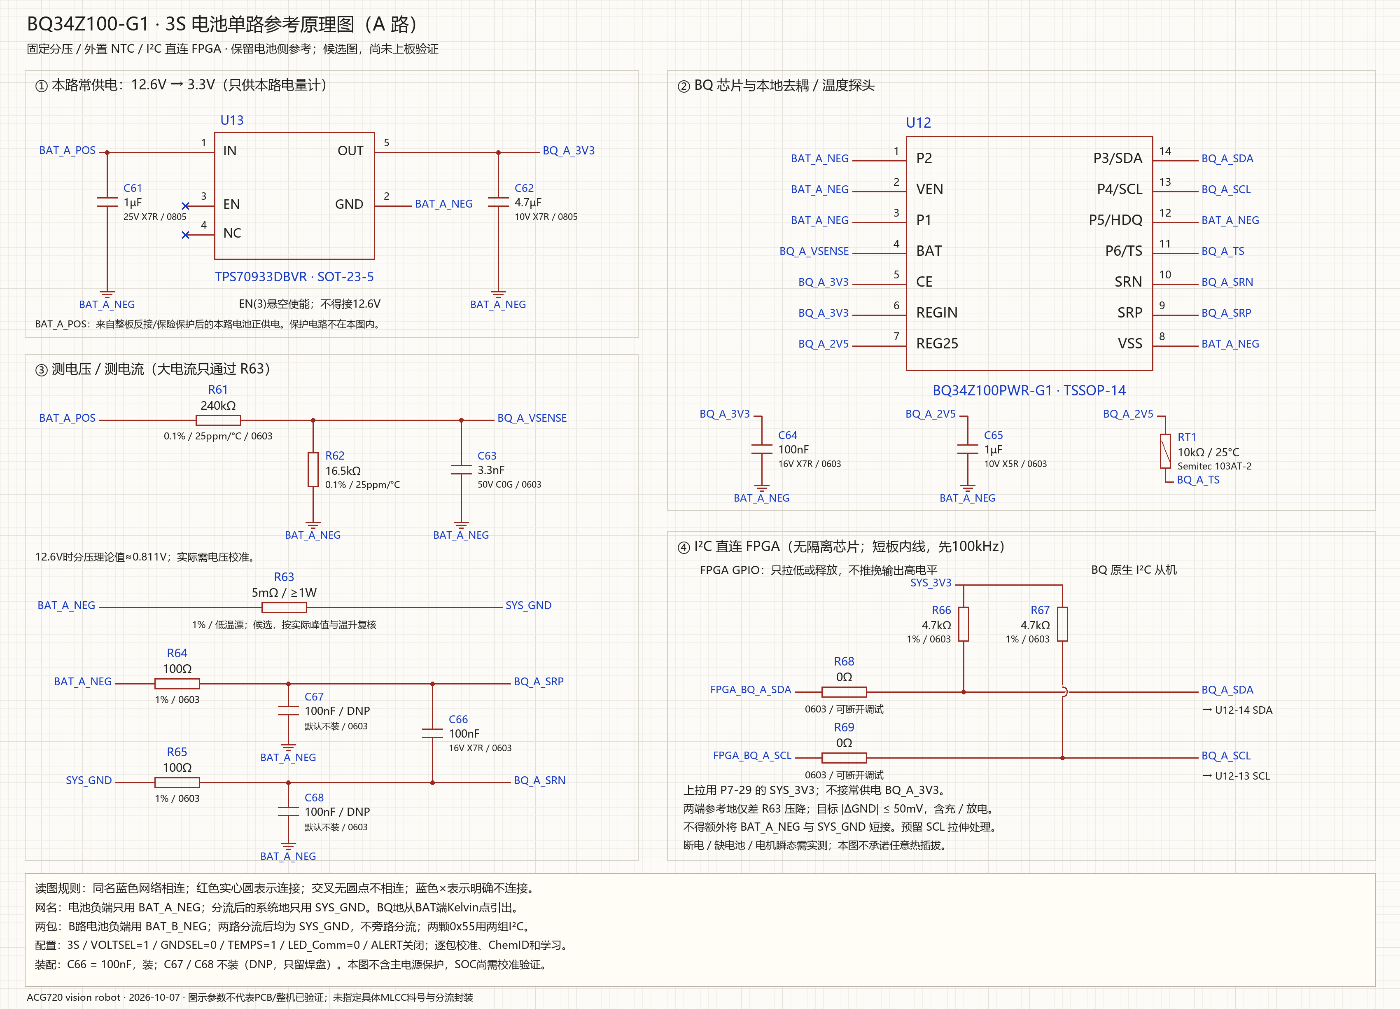
docs/bq34z100-g1_3s_reference.png
