Vera-loves-program/acg720-vision-robot/src/robot_status_text.v

// Compact atomic text: six fields, one20-bit serial decimal datapath.
module robot_status_text #(parameter integer CLK_HZ=50000000,parameter integer PARALLEL_COMPAT=1)(
    input wire clk,reset_n,
    input wire [2:0] page,subpage,
    input wire [15:0] follow_selected,follow_candidate,
    input wire [7:0] follow_kind,follow_confidence,follow_state,
    input wire signed [15:0] follow_speed,
    input wire [7:0] follow_gain,planner_error,follow_diagnostic,follow_dog_score,
    input wire waiting_map,
    input wire waiting_path,
    input wire [15:0] follow_cap,follow_pan_us,follow_tilt_us,
    input wire signed [15:0] visual_x,visual_y,
    input wire armed,geometry_valid,gyro_calibrated,calibrating,lidar_ready,scan_enable,safety_stop,map_ready,gains_ready,
    input wire map_local,map_world_ready,
    input wire motor_armed,motor_running,motor_selected_wheel,motor_mode_position,
    input wire encoder_invert_left,encoder_invert_right,drive_invert_left,drive_invert_right,
    input wire calibration_enable,manual_active,manual_turn_active,manual_linked,gyro_invert,
    input wire [3:0] nav_status,ui_notice,
    input wire [4:0] selected_field,
    input wire virtual_contact,
    input wire [2:0] recovery_state,
    input wire [15:0] body_self_points,
    input wire signed [15:0] blocking_x_mm,blocking_y_mm,
    input wire [7:0] nav_fault,lidar_error,motor_fault,
    input wire signed [31:0] selected_value,x_mm,y_mm,heading_mdeg,goal_x_mm,goal_y_mm,
    input wire signed [31:0] speed_left,speed_right,position_left,position_right,
    input wire signed [31:0] set_x_mm,set_y_mm,set_heading_mdeg,
    input wire signed [15:0] duty_left,duty_right,gyro_raw,lidar_offset_x_mm,lidar_offset_y_mm,
    input wire signed [15:0] motor_target_left,motor_target_right,
    input wire signed [31:0] motor_position_target_left,motor_position_target_right,
    input wire [15:0] speed_kp_left,speed_kp_right,speed_ki_left,speed_ki_right,speed_kd_left,speed_kd_right,
    input wire [15:0] position_kp_left,position_kp_right,position_ki_left,position_ki_right,position_kd_left,position_kd_right,
    input wire [31:0] selected_step,lidar_points,
    input wire [31:0] rx_bytes,node_count,uart_errors,packet_errors,restart_count,map_points,map_scans,
    input wire [31:0] map_dropped,
    input wire [31:0] lidar_debug_status,lidar_last_rx_word,
    input wire [127:0] lidar_reply_capture,
    input wire [31:0] lidar_last_tx_word,
    input wire [15:0] front_mm,left_mm,right_mm,rear_mm,
    input wire [15:0] manual_speed_left,manual_speed_right,wheel_mm_per_rev,encoder_counts_per_rev,track_mm,
    input wire [15:0] cruise_counts,turn_counts,
    input wire [8:0] lidar_zero_deg,
    input wire [7:0] match_score,match_baseline,match_margin,
    output wire [2047:0] text_rows,
    output reg [31:0] flags,
    output reg text_valid,
    output wire text_byte_valid,
    output wire [7:0] text_byte_data,
    output wire [7:0] text_byte_index,
    input wire text_byte_ready
);
    (* syn_romstyle="block_rom" *) reg [7:0] labels[0:2047];
    integer init_index;
    initial begin
        for(init_index=0;init_index<1024;init_index=init_index+1)begin labels[init_index]=8'h20;labels[init_index+1024]=8'h20;end
        // 1: WAIT USB CAMERA
        labels[16]=8'h57;
        labels[17]=8'h41;
        labels[18]=8'h49;
        labels[19]=8'h54;
        labels[21]=8'h55;
        labels[22]=8'h53;
        labels[23]=8'h42;
        labels[25]=8'h43;
        labels[26]=8'h41;
        labels[27]=8'h4d;
        labels[28]=8'h45;
        labels[29]=8'h52;
        labels[30]=8'h41;
        // 2: CAMERA ERROR
        labels[32]=8'h43;
        labels[33]=8'h41;
        labels[34]=8'h4d;
        labels[35]=8'h45;
        labels[36]=8'h52;
        labels[37]=8'h41;
        labels[39]=8'h45;
        labels[40]=8'h52;
        labels[41]=8'h52;
        labels[42]=8'h4f;
        labels[43]=8'h52;
        // 3: NO DOG IN VIEW
        labels[48]=8'h4e;
        labels[49]=8'h4f;
        labels[51]=8'h44;
        labels[52]=8'h4f;
        labels[53]=8'h47;
        labels[55]=8'h49;
        labels[56]=8'h4e;
        labels[58]=8'h56;
        labels[59]=8'h49;
        labels[60]=8'h45;
        labels[61]=8'h57;
        // 4: DOG SCORE LOW
        labels[64]=8'h44;
        labels[65]=8'h4f;
        labels[66]=8'h47;
        labels[68]=8'h53;
        labels[69]=8'h43;
        labels[70]=8'h4f;
        labels[71]=8'h52;
        labels[72]=8'h45;
        labels[74]=8'h4c;
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
        labels[1648]=8'h46;
        labels[1649]=8'h41;
        labels[1650]=8'h43;
        labels[1651]=8'h45;
        labels[1653]=8'h54;
        labels[1654]=8'h52;
        labels[1655]=8'h41;
        labels[1656]=8'h43;
        labels[1657]=8'h4b;
        labels[1658]=8'h49;
        labels[1659]=8'h4e;
        labels[1660]=8'h47;
        // 104: SEARCHING FACE
        labels[1664]=8'h53;
        labels[1665]=8'h45;
        labels[1666]=8'h41;
        labels[1667]=8'h52;
        labels[1668]=8'h43;
        labels[1669]=8'h48;
        labels[1670]=8'h49;
        labels[1671]=8'h4e;
        labels[1672]=8'h47;
        labels[1674]=8'h46;
        labels[1675]=8'h41;
        labels[1676]=8'h43;
        labels[1677]=8'h45;
        // 105: FACE NOT FOUND
        labels[1680]=8'h46;
        labels[1681]=8'h41;
        labels[1682]=8'h43;
        labels[1683]=8'h45;
        labels[1685]=8'h4e;
        labels[1686]=8'h4f;
        labels[1687]=8'h54;
        labels[1689]=8'h46;
        labels[1690]=8'h4f;
        labels[1691]=8'h55;
        labels[1692]=8'h4e;
        labels[1693]=8'h44;
        // 106: FACE POSITION
        labels[1696]=8'h46;
        labels[1697]=8'h41;
        labels[1698]=8'h43;
        labels[1699]=8'h45;
        labels[1701]=8'h50;
        labels[1702]=8'h4f;
        labels[1703]=8'h53;
        labels[1704]=8'h49;
        labels[1705]=8'h54;
        labels[1706]=8'h49;
        labels[1707]=8'h4f;
        labels[1708]=8'h4e;
        // 107: HEAD TO 135
        labels[1712]=8'h48;
        labels[1713]=8'h45;
        labels[1714]=8'h41;
        labels[1715]=8'h44;
        labels[1717]=8'h54;
        labels[1718]=8'h4f;
        labels[1720]=8'h31;
        labels[1721]=8'h33;
        labels[1722]=8'h35;
        // 108: MOTION PAUSED
        labels[1728]=8'h4d;
        labels[1729]=8'h4f;
        labels[1730]=8'h54;
        labels[1731]=8'h49;
        labels[1732]=8'h4f;
        labels[1733]=8'h4e;
        labels[1735]=8'h50;
        labels[1736]=8'h41;
        labels[1737]=8'h55;
        labels[1738]=8'h53;
        labels[1739]=8'h45;
        labels[1740]=8'h44;
        // 109: WAIT CLEAR PATH
        labels[1744]=8'h57;
        labels[1745]=8'h41;
        labels[1746]=8'h49;
        labels[1747]=8'h54;
        labels[1749]=8'h43;
        labels[1750]=8'h4c;
        labels[1751]=8'h45;
        labels[1752]=8'h41;
        labels[1753]=8'h52;
        labels[1755]=8'h50;
        labels[1756]=8'h41;
        labels[1757]=8'h54;
        labels[1758]=8'h48;
    end

    // Six frozen20-bit values, one serial BCD converter and one2KB byte ROM.
    // No PID fractional formatter, debug capture bank, page editor, parallel
    // numeric conversions or live32-bit23-way field multiplexer remains.
    localparam S_IDLE=0,S_ROW=1,S_CONVERT=2,S_REQUEST=3,S_SEND=4,S_COMMIT=5;
    reg [2:0] state;
    reg [31:0] countdown,held_flags;
    reg [3:0] row,column;
    reg [6:0] title_id,status_id,current_label;
    reg [6:0] prefixes[0:5];
    reg signed [19:0] values[0:5];
    reg [5:0] numeric_mask,unknown_mask,degrees_mask;
    reg numeric_row,unknown_value,negative,started;
    reg [19:0] shift;
    reg [23:0] bcd,render_bcd;
    reg [4:0] bit_count;
    reg [7:0] label_byte;
    wire [5:0] view={page,subpage};
    wire [2:0] value_index=row[2:0]-3'd2;
    wire signed [19:0] selected_raw=values[value_index];
    wire [19:0] magnitude=selected_raw[19] ? -selected_raw : selected_raw;
    wire [23:0] adjusted_bcd;
    genvar digit;
    generate for(digit=0;digit<6;digit=digit+1)begin:bcd_adjust
        assign adjusted_bcd[digit*4+:4]=bcd[digit*4+:4]>=5 ? bcd[digit*4+:4]+4'd3 : bcd[digit*4+:4];
    end endgenerate
    wire [23:0] next_bcd={adjusted_bcd[22:0],shift[19]};
    wire [3:0] current_digit=render_bcd[23:20];
    wire [7:0] digit_byte=unknown_value ? 8'h2d : !started && current_digit==0 && column!=12 ? 8'h20 : 8'h30+{4'd0,current_digit};
    wire [7:0] numeric_byte=column==6 ? (unknown_value ? 8'h20 : negative ? 8'h2d : 8'h2b) :
        column>=7 && column<=12 ? digit_byte : 8'h20;
    assign text_byte_valid=state==S_SEND;
    assign text_byte_data=numeric_row && column>=5 ? numeric_byte : label_byte;
    assign text_byte_index={row,column};
    function [6:0] navigation_label;
        input [3:0] s;
        begin case(s)
            1:navigation_label=29;2:navigation_label=30;3,5:navigation_label=24;
            4:navigation_label=21;6:navigation_label=25;7:navigation_label=57;
            8:navigation_label=61;9:navigation_label=50;10:navigation_label=55;
            11:navigation_label=56;default:navigation_label=20;
        endcase end
    endfunction
    function [6:0] planner_label;
        input [7:0] s;
        begin case(s)
            1:planner_label=88;2:planner_label=85;3:planner_label=86;4:planner_label=87;
            8:planner_label=22;9:planner_label=23;11:planner_label=89;12:planner_label=90;
            13:planner_label=92;14:planner_label=93;15:planner_label=94;16:planner_label=95;
            17:planner_label=96;18:planner_label=97;19:planner_label=98;20:planner_label=99;21:planner_label=108;
            default:planner_label=56;
        endcase end
    endfunction
    reg [6:0] live_status,live_title;
    always @* begin
        live_title=40;
        case(view)
            1:live_title=41;32:live_title=42;19:live_title=43;33:live_title=44;
            40:live_title=45;43:live_title=46;44:live_title=58;27:live_title=59;17:live_title=60;
            default:begin end
        endcase
        live_status=armed ? navigation_label(nav_status) : 7'd20;
        if(ui_notice==9)live_status=49;
        else if(ui_notice==2)live_status=30;
        else if(ui_notice==3 || calibrating)live_status=29;
        else if(ui_notice==5)live_status=28;
        if((view==33 || view==43) && nav_status==11)live_status=planner_label(planner_error);
        if((view==33 || view==43) && waiting_map)live_status=91;
        else if((view==33 || view==43) && waiting_path && planner_error==0)live_status=109;
        if(page==5)begin
            live_status=follow_diagnostic<=39 && follow_diagnostic!=0 ? {1'b0,follow_diagnostic[5:0]} :
                follow_state==4 ? 7'd16 : follow_state==8 ? 7'd24 : 7'd9;
            if(follow_diagnostic>=40 && follow_diagnostic<=47)live_status=7'd100+{1'b0,follow_diagnostic[5:0]}-7'd40;
            if(armed && nav_status>=4 && follow_state<12)live_status=nav_status==11 ? planner_label(planner_error) : navigation_label(nav_status);
            if(follow_state==0)live_status=26;
            if(follow_state==12)live_status=27;
            if(follow_state==13)live_status=14;
            if(follow_state==21)live_status=(follow_diagnostic==12 || follow_diagnostic==13) ? {1'b0,follow_diagnostic[5:0]} : 7'd19;
        end
        if(motor_fault!=0)live_status=50;
        if(safety_stop)live_status=51;
    end
    integer field;
    generate if(PARALLEL_COMPAT!=0)begin:compatibility_only
        reg [2047:0] work,published;
        assign text_rows=published;
        always @(posedge clk or negedge reset_n)begin
            if(!reset_n)begin work<=0;published<=0;end
            else begin
                if(text_byte_valid && text_byte_ready)work[2047-({row,column}*8)-:8]<=text_byte_data;
                if(state==S_COMMIT)published<=work;
            end
        end
    end else begin:no_parallel_display
        assign text_rows=2048'd0;
    end endgenerate
    always @(posedge clk or negedge reset_n)begin
        if(!reset_n)begin
            state<=S_IDLE;countdown<=0;row<=0;column<=0;title_id<=0;status_id<=20;current_label<=0;
            held_flags<=0;flags<=0;text_valid<=0;numeric_mask<=0;unknown_mask<=0;degrees_mask<=0;
            numeric_row<=0;unknown_value<=0;negative<=0;started<=0;
            shift<=0;bcd<=0;render_bcd<=0;bit_count<=0;label_byte<=8'h20;
            for(field=0;field<6;field=field+1)begin values[field]<=0;prefixes[field]<=0;end
        end else begin
            text_valid<=0;
            if(countdown!=0)countdown<=countdown-1'b1;
            case(state)
                S_IDLE:if(countdown==0)begin
                    countdown<=CLK_HZ/10;
                    // Stable wire contract used by panel, map and motor owners.
                    held_flags<={gains_ready,subpage,lidar_error[4:0],nav_fault,nav_status,map_ready,safety_stop,scan_enable,
                        lidar_ready,calibrating,gyro_calibrated,geometry_valid,armed,page};
                    title_id<=live_title;status_id<=live_status;
                    numeric_mask<=0;unknown_mask<=0;degrees_mask<=0;
                    for(field=0;field<6;field=field+1)begin values[field]<=0;prefixes[field]<=0;end
                    case(view)
                        32:begin
                            numeric_mask<=6'b011111;degrees_mask[4]<=1;
                            values[0]<=$signed({4'd0,manual_speed_left});prefixes[0]<=74;
                            values[1]<=$signed({4'd0,manual_speed_right});prefixes[1]<=75;
                            values[2]<=speed_left[19:0];prefixes[2]<=76;
                            values[3]<=speed_right[19:0];prefixes[3]<=77;
                            values[4]<=heading_mdeg[19:0];prefixes[4]<=67;
                        end
                        33:begin
                            numeric_mask<=6'b011111;degrees_mask[2]<=1;
                            values[0]<=x_mm[19:0];prefixes[0]<=65;values[1]<=y_mm[19:0];prefixes[1]<=66;
                            values[2]<=heading_mdeg[19:0];prefixes[2]<=67;
                            values[3]<=goal_x_mm[19:0];prefixes[3]<=68;values[4]<=goal_y_mm[19:0];prefixes[4]<=69;
                        end
                        27:begin
                            numeric_mask<=6'b000111;
                            values[0]<=goal_x_mm[19:0];prefixes[0]<=68;values[1]<=goal_y_mm[19:0];prefixes[1]<=69;
                            values[2]<=selected_step[19:0];prefixes[2]<=83;
                        end
                        19:begin
                            numeric_mask<=6'b011111;
                            values[0]<=$signed({4'd0,front_mm});prefixes[0]<=78;
                            values[1]<=$signed({4'd0,left_mm});prefixes[1]<=79;
                            values[2]<=$signed({4'd0,right_mm});prefixes[2]<=80;
                            values[3]<=$signed({4'd0,rear_mm});prefixes[3]<=81;
                            values[4]<=$signed({11'd0,lidar_zero_deg});prefixes[4]<=82;
                            unknown_mask[3:0]<={rear_mm<50 || rear_mm>16000,right_mm<50 || right_mm>16000,left_mm<50 || left_mm>16000,front_mm<50 || front_mm>16000};
                        end
                        17:begin
                            numeric_mask<=6'b111111;degrees_mask[2]<=1;
                            values[0]<=x_mm[19:0];prefixes[0]<=65;values[1]<=y_mm[19:0];prefixes[1]<=66;
                            values[2]<=heading_mdeg[19:0];prefixes[2]<=67;
                            values[3]<=$signed({4'd0,front_mm});prefixes[3]<=78;
                            values[4]<=$signed({4'd0,left_mm});prefixes[4]<=79;
                            values[5]<=$signed({4'd0,right_mm});prefixes[5]<=80;
                            unknown_mask[5:3]<={right_mm<50 || right_mm>16000,left_mm<50 || left_mm>16000,front_mm<50 || front_mm>16000};
                        end
                        40,43,44:begin
                            numeric_mask<=view==43 ? 6'b001111 : view==44 ? 6'b000111 : 6'b000011;
                            values[0]<=$signed({4'd0,follow_selected});prefixes[0]<=70;
                            values[1]<=$signed({12'd0,follow_dog_score});prefixes[1]<=71;
                            if(view==43)begin
                                values[2]<={{4{visual_x[15]}},visual_x};prefixes[2]<=72;
                                values[3]<={{4{visual_y[15]}},visual_y};prefixes[3]<=73;
                            end else begin values[2]<={{4{follow_speed[15]}},follow_speed};prefixes[2]<=84;end
                        end
                        default:begin end
                    endcase
                    row<=0;column<=0;state<=S_ROW;
                end
                S_ROW:begin
                    column<=0;started<=0;numeric_row<=0;unknown_value<=0;
                    if(row==0)begin current_label<=title_id;state<=S_REQUEST;end
                    else if(row==1)begin current_label<=status_id;state<=S_REQUEST;end
                    else if(row>=2 && row<=7 && numeric_mask[value_index])begin
                        current_label<=prefixes[value_index];numeric_row<=1;unknown_value<=unknown_mask[value_index];
                        negative<=selected_raw[19];shift<=magnitude;bcd<=0;bit_count<=0;state<=S_CONVERT;
                    end else begin
                        current_label<=row==8 ? 7'd52 : row==9 ? (!held_flags[8] ? 7'd54 : held_flags[7] ? 7'd53 : 7'd28) : row==10 ? 7'd47 : 7'd0;
                        state<=S_REQUEST;
                    end
                end
                S_CONVERT:begin
                    bcd<=next_bcd;shift<=shift<<1;
                    if(bit_count==19)begin
                        render_bcd<=degrees_mask[value_index] ? {12'd0,next_bcd[23:12]} : next_bcd;
                        state<=S_REQUEST;
                    end else bit_count<=bit_count+1'b1;
                end
                S_REQUEST:begin label_byte<=labels[{current_label,column}];state<=S_SEND;end
                S_SEND:if(text_byte_ready)begin
                    if(numeric_row && column>=7 && column<=12)begin
                        if(current_digit!=0 || column==12)started<=1;
                        render_bcd<=render_bcd<<4;
                    end
                    if(column==15)begin
                        if(row==15)state<=S_COMMIT;
                        else begin row<=row+1'b1;column<=0;state<=S_ROW;end
                    end else begin column<=column+1'b1;state<=S_REQUEST;end
                end
                S_COMMIT:begin flags<=held_flags;text_valid<=1;state<=S_IDLE;end
                default:state<=S_IDLE;
            endcase
        end
    end
endmodule
