Vera-loves-program/acg720-vision-robot/src/robot_control_panel.v

// Generated from tools/robot_ui_spec.py; edit the shared specification.
// Main page stays 3 bits. Subpage occupies flags[30:28]; flags[31] is gains.
// Compact descriptors preserve the existing layout/character/glyph/RGB pipe.
module robot_control_panel (
    input wire [10:0] x,
    input wire [9:0] y,
    input wire [31:0] flags,
    input wire [1:0] map_cell,
    input wire [39:0] map_car_model,
    input wire map_read_valid,
    output wire map_read_en,
    output wire [6:0] map_read_x,map_read_y,
    output reg [2:0] label_source,
    output reg [3:0] label_row,
    output reg [6:0] label_literal,
    output reg [10:0] label_x,label_right,
    output reg [9:0] label_y,
    output reg [15:0] label_color,base_color,
    output reg label_enable,override_label,override_base
);
    localparam [15:0] BG=16'hf79e,WHITE=16'hffff,INK=16'h1926,BLUE=16'h03df,
        SOFT=16'he79f,RED=16'hd965,GREEN=16'h13a8,MUTED=16'h63b1;
    wire [2:0] page=flags[2:0],subpage=flags[30:28];
    wire [5:0] view={page,subpage};
    reg [2:0] view_kind;
    always @* begin
        case(view)
            6'd0:view_kind=3'd0;
            6'd19,6'd27,6'd32,6'd33,6'd40,6'd43,6'd44:view_kind=3'd1;
            6'd1:view_kind=3'd2;
            6'd17:view_kind=3'd3;
            default:view_kind=3'd5;
        endcase
    end
    wire [7:0] hit_button;
    robot_ui_hit_test u_pixel_hit(.x(x),.y(y),.page(page),.subpage(subpage),.button(hit_button));
    wire in_map=x>=32 && x<288 && y>=112 && y<368;
    wire map_prefetch=x>=31 && x<287 && y>=112 && y<368;
    wire [10:0] map_x_wide=(x-11'd31)>>1;
    wire [9:0] map_y_wide=(10'd367-y)>>1;
    assign map_read_en=page==2 && subpage==1 && map_prefetch;
    assign map_read_x=map_x_wide[6:0];
    assign map_read_y=map_y_wide[6:0];
    wire [10:0] car_draw_x=(x-11'd32)>>1;
    wire signed [8:0] car_dx=$signed({2'b00,car_draw_x[6:0]})-$signed({2'b00,map_car_model[15:9]});
    wire signed [8:0] car_dy=$signed({2'b00,map_y_wide[6:0]})-$signed({2'b00,map_car_model[8:2]});
    wire car_origin=(car_dx==0 && car_dy>=-1 && car_dy<=1) || (car_dy==0 && car_dx>=-1 && car_dx<=1);
    reg car_arrow;
    always @* begin
        case(map_car_model[38:36])
            0:car_arrow=car_dy==0 && car_dx>0 && car_dx<=3;
            1:car_arrow=car_dx==car_dy && car_dx>0 && car_dx<=2;
            2:car_arrow=car_dx==0 && car_dy>0 && car_dy<=3;
            3:car_arrow=car_dx== -car_dy && car_dy>0 && car_dy<=2;
            4:car_arrow=car_dy==0 && car_dx<0 && car_dx>=-3;
            5:car_arrow=car_dx==car_dy && car_dx<0 && car_dx>=-2;
            6:car_arrow=car_dx==0 && car_dy<0 && car_dy>=-3;
            default:car_arrow=car_dx== -car_dy && car_dx>0 && car_dx<=2;
        endcase
    end
    wire [3:0] info_line=(y-10'd132)>>5;
    wire info_line_pixel=y>=132 && y<308 && (y[4:0]>=4 && y[4:0]<20);
    wire [3:0] map_info_line=(y-10'd80)>>5;
    wire map_info_pixel=y>=80 && y<256 && y[4:0]>=16;
    wire [9:0] diag_dy=y-10'd332;
    wire [2:0] diag_line=diag_dy[7:5];
    wire diag_pixel=y>=332 && y<476 && diag_dy[4:0]<16;
    reg [10:0] button_text_x,button_label_right;
    reg [9:0] button_text_y;
    reg [6:0] button_caption;
    wire stop_button=hit_button==106 || (view==6'd9 && hit_button==4) ||
        ((view==6'd10 || view==6'd11) && hit_button==2) ||
        ((view==6'd32 || view==6'd33) && hit_button==6) ||
        ((view==6'd40 && (hit_button==3 || hit_button==7)) || (view==6'd43 && (hit_button==6 || hit_button==7)) || (view==6'd44 && (hit_button==4 || hit_button==7))) ||
        (view==6'd41 && hit_button==4) || (view==6'd19 && hit_button==2);
    function rect;
        input [10:0] px,left,right;
        input [9:0] py,top,bottom;
        begin rect=px>=left && px<right && py>=top && py<bottom;end
    endfunction
    function [6:0] view_caption;
        input [5:0] view;
        input [3:0] slot;
        begin
            view_caption=0;
            case(view)
                6'd0:case(slot)
                    4'd1:view_caption=7'd5;
                    4'd2:view_caption=7'd6;
                    4'd3:view_caption=7'd7;
                    4'd4:view_caption=7'd8;
                    4'd5:view_caption=7'd9;
                    4'd6:view_caption=7'd10;
                    default:view_caption=0;
                endcase
                6'd17:case(slot)
                    4'd1:view_caption=7'd2;
                    4'd2:view_caption=7'd15;
                    default:view_caption=0;
                endcase
                6'd19:case(slot)
                    4'd1:view_caption=7'd18;
                    4'd2:view_caption=7'd19;
                    4'd3:view_caption=7'd20;
                    4'd4:view_caption=7'd21;
                    default:view_caption=0;
                endcase
                6'd27:case(slot)
                    4'd1:view_caption=7'd24;
                    4'd2:view_caption=7'd25;
                    4'd3:view_caption=7'd26;
                    4'd4:view_caption=7'd27;
                    4'd5:view_caption=7'd28;
                    4'd6:view_caption=7'd29;
                    default:view_caption=0;
                endcase
                6'd32:case(slot)
                    4'd1:view_caption=7'd32;
                    4'd2:view_caption=7'd33;
                    4'd3:view_caption=7'd34;
                    4'd4:view_caption=7'd35;
                    4'd5:view_caption=7'd36;
                    4'd6:view_caption=7'd19;
                    default:view_caption=0;
                endcase
                6'd33:case(slot)
                    4'd1:view_caption=7'd39;
                    4'd2:view_caption=7'd40;
                    4'd3:view_caption=7'd41;
                    4'd4:view_caption=7'd42;
                    4'd5:view_caption=7'd43;
                    4'd6:view_caption=7'd19;
                    default:view_caption=0;
                endcase
                6'd40:case(slot)
                    4'd1:view_caption=7'd44;
                    4'd2:view_caption=7'd45;
                    4'd3:view_caption=7'd46;
                    4'd7:view_caption=7'd47;
                    default:view_caption=0;
                endcase
                6'd43:case(slot)
                    4'd1:view_caption=7'd50;
                    4'd2:view_caption=7'd51;
                    4'd3:view_caption=7'd52;
                    4'd4:view_caption=7'd53;
                    4'd5:view_caption=7'd54;
                    4'd6:view_caption=7'd19;
                    4'd7:view_caption=7'd47;
                    default:view_caption=0;
                endcase
                6'd44:case(slot)
                    4'd1:view_caption=7'd44;
                    4'd2:view_caption=7'd57;
                    4'd3:view_caption=7'd58;
                    4'd4:view_caption=7'd19;
                    4'd7:view_caption=7'd47;
                    default:view_caption=0;
                endcase
                default:view_caption=0;
            endcase
        end
    endfunction
    function [6:0] view_hint;
        input [5:0] view;
        begin case(view)
            6'd0:view_hint=7'd11;
            6'd1:view_hint=7'd13;
            6'd17:view_hint=7'd16;
            6'd19:view_hint=7'd22;
            6'd27:view_hint=7'd30;
            6'd32:view_hint=7'd37;
            6'd33:view_hint=7'd30;
            6'd40:view_hint=7'd48;
            6'd43:view_hint=7'd55;
            6'd44:view_hint=7'd59;
            default:view_hint=7'd0;
        endcase end
    endfunction
    function [6:0] view_detail;
        input [5:0] view;
        begin case(view)
            6'd0:view_detail=7'd12;
            6'd1:view_detail=7'd14;
            6'd17:view_detail=7'd17;
            6'd19:view_detail=7'd23;
            6'd27:view_detail=7'd31;
            6'd32:view_detail=7'd38;
            6'd33:view_detail=7'd31;
            6'd40:view_detail=7'd49;
            6'd43:view_detail=7'd56;
            6'd44:view_detail=7'd60;
            default:view_detail=7'd0;
        endcase end
    endfunction
    // Fixed text anchors avoid variable subtract/add/centering hardware.
    // Fill and touch both use the SINGLE shared hit-test module above.
    always @* begin
        button_text_x=0;button_label_right=0;button_text_y=0;button_caption=0;
        if(hit_button>=100)begin
            button_text_x=840;button_label_right=1004;
            case(hit_button)
                100:begin button_text_y=80;button_caption=7'd1;end
                101:begin button_text_y=152;button_caption=7'd2;end
                105:begin button_text_y=414;button_caption=7'd3;end
                106:begin button_text_y=500;button_caption=7'd4;end
                default:begin end
            endcase
        end else if(hit_button!=0)begin
            button_caption=view_caption(view,hit_button[3:0]);
            if(view_kind==0)begin
                button_text_x=hit_button[0] ? 48 : 448;button_label_right=hit_button[0] ? 380 : 780;
                if(hit_button<=2)button_text_y=160;
                else if(hit_button<=4)button_text_y=272;else button_text_y=384;
            end else if(view_kind==3)begin
                button_text_x=hit_button[0] ? 448 : 628;button_label_right=hit_button[0] ? 616 : 796;
                button_text_y=hit_button<=2 ? 366 : 422;
            end else if(view_kind==4)begin
                button_text_x=hit_button[0] ? 40 : 440;
                button_label_right=hit_button[0] ? 380 : 780;
                button_text_y=476;
            end else if(hit_button<=6)begin
                button_text_x=hit_button[0] ? 416 : 616;button_label_right=hit_button[0] ? 592 : 792;
                if(hit_button<=2)button_text_y=150;
                else if(hit_button<=4)button_text_y=238;else button_text_y=326;
            end else begin
                button_text_x=hit_button==8 ? 216 : 40;
                button_label_right=(view==6'd32 || view==6'd33) && hit_button==7 ? 188 : 380;
                button_text_y=454;
            end
        end
    end
    always @* begin
        label_source=0;label_row=0;label_literal=0;label_x=0;label_right=1024;label_y=0;
        label_color=INK;label_enable=0;override_label=1;override_base=0;base_color=BG;
        if(view_kind!=2 && rect(x,16,816,y,56,536))begin
            override_base=1;
            if(view_kind==1 && x>=28 && x<388 && y>=116 && y<(view==16 ? 500 : 416))base_color=WHITE;
            if(view_kind==4 && y>=112 && y<444 && ((x>=32 && x<384)||(x>=432 && x<784)))base_color=WHITE;
            if(view_kind==3 && in_map)base_color=!map_read_valid ? 16'h8410 :
                map_cell==0 ? 16'hc618 : map_cell==1 ? WHITE : map_cell==2 ? 16'h45f2 : 16'h18e3;
            if(view_kind==3 && in_map && map_car_model[39])begin
                if(car_origin)base_color=BLUE;
                if(car_arrow)base_color=16'hffe0;
                if(car_origin)base_color=RED;
            end
        end
        if(rect(x,824,1016,y,52,540))begin override_base=1;base_color=WHITE;end
        if(hit_button!=0)begin
            override_base=1;base_color=stop_button ? RED : SOFT;
            if(hit_button==100)base_color=BLUE;
            if(view_kind==3 && x==619)base_color=WHITE;
            // Touch rectangles are much larger than their centered text.
            label_enable=1;label_literal=button_caption;
            label_x=button_text_x;label_right=button_label_right;label_y=button_text_y;
            label_color=stop_button || hit_button==100 ? WHITE : BLUE;
        end
        if(view_kind==0 && y>=88 && y<104)begin
            label_enable=1;label_y=88;
            if(x>=32 && x<384)begin label_x=32;label_right=384;label_literal=view_hint(view);end
            else if(x>=432 && x<784)begin label_x=432;label_right=784;label_literal=view_detail(view);label_color=MUTED;end
            else label_enable=0;
        end
        if(view_kind==1 && x>=36 && x<388 && info_line_pixel)begin
            label_enable=1;label_x=36;label_right=388;
            label_y=10'd132+({6'd0,info_line}<<5);label_source=1;label_row=info_line+4'd2;
        end
        if(view_kind==1 && x>=36 && x<388 && ((y>=376 && y<392)||(y>=400 && y<416)))begin
            label_enable=1;label_source=0;label_x=36;label_right=388;label_color=MUTED;
            label_y=y<392 ? 376 : 400;label_literal=y<392 ? view_hint(view) : view_detail(view);
        end
        if(view_kind==3 && x>=448 && x<800 && map_info_pixel)begin
            label_enable=1;label_source=1;label_row=map_info_line+4'd2;
            label_x=448;label_right=800;label_y=10'd80+({6'd0,map_info_line}<<5);
        end
        if(view_kind==3 && x>=28 && x<412 && y>=408 && y<424)begin
            label_enable=1;label_literal=7'd16;label_x=28;label_right=412;label_y=408;label_color=MUTED;
        end
        // Exactly four concise status lines, common across all levels.
        if(x>=824 && x<1024 && y>=224 && y<336 && y[4:0]<16)begin
            label_enable=1;label_source=1;label_x=824;label_right=1024;
            label_y={y[9:5],5'd0};
            case(y[6:5])
                3:label_row=1;0:label_row=8;1:label_row=9;default:label_row=10;
            endcase
            if(flags[9])label_color=RED;
        end
        if(y>=14 && y<30)begin
            label_enable=1;label_y=14;
            if(x>=20 && x<280)begin label_x=20;label_right=280;label_source=1;label_row=0;end
            else if(x>=300 && x<560)begin label_x=300;label_right=560;label_source=4;label_row=0;end
            else if(x>=600 && x<820)begin label_x=600;label_right=820;label_source=4;label_row=1;end
            else label_enable=0;
        end
        if((y>=558 && y<574)||(y>=582 && y<598))begin
            label_enable=1;label_source=3;label_y=y<574 ? 558 : 582;label_color=y<574 ? INK : MUTED;
            if(x>=20 && x<280)begin label_x=20;label_right=280;label_row=y<574 ? 1 : 4;end
            else if(x>=300 && x<560)begin label_x=300;label_right=560;label_row=y<574 ? 2 : 5;end
            else if(x>=600 && x<820)begin label_x=600;label_right=820;label_row=y<574 ? 3 : 6;end
            else label_enable=0;
        end
    end
endmodule
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
