Vera-loves-program/acg720-vision-robot/src/robot_mission_control.v

// Preserve one user goal while the local navigator follows safe map waypoints.
// No automatic reverse is issued by this module. A blockage parks the drive,
// waits for fresh stationary scan integrations, then freezes a known-free map
// for body-inflated BFS. Unknown space is blocked.
// Recoverable map/obstacle/sensor failures park the SAME mission and retry
// only after a new eligible completed map. Explicit STOP/manual takeover and
// safety_stop cancel; ARRIVED finishes. No automatic physical fault clearing.
module robot_mission_control (
    input wire clk,reset_n,tick_10ms,permit,safety_stop,
    input wire user_command_valid,
    input wire [2:0] user_command,
    input wire signed [31:0] user_goal_x,user_goal_y,
    input wire signed [31:0] pose_x,pose_y,
    input wire pose_valid,
    input wire [3:0] nav_status,
    input wire virtual_contact,rear_clear,
    input wire [15:0] recovery_counts,
    input wire map_ready,map_busy,map_capture_ready,scan_complete,
    input wire capture_boundary,
    input wire [15:0] scan_id,map_integrated_id,
    input wire map_integrated_valid,map_integrated_pulse,
    input wire [31:0] map_scan_count,
    input wire planner_busy,planner_done,planner_reachable,
    input wire [6:0] planner_next_x,planner_next_y,
    output reg planner_start,
    output wire planner_cancel,
    output wire [6:0] planner_current_x,planner_current_y,planner_goal_x,planner_goal_y,
    output reg nav_command_valid,
    output reg [2:0] nav_command,
    output reg signed [31:0] nav_goal_x,nav_goal_y,
    output reg [15:0] nav_arrival_tolerance_mm,
    output wire motion_permit,
    output wire waiting_map,
    output reg waiting_path,
    output reg [7:0] mission_error,
    output reg planning,no_path,mission_active,
    output reg [2:0] recovery_state,
    output wire signed [15:0] recovery_speed
);
    reg detouring,wait_depart,pending;
    reg [1:0] settle_ticks;
    reg [2:0] pending_command;
    reg signed [31:0] pending_x,pending_y;
    reg signed [31:0] final_x,final_y;
    reg refreshing_map;
    reg refresh_phase;
    reg [15:0] required_capture_id;
    reg [8:0] refresh_ticks;
    reg [5:0] map_age_ticks;
    reg invalid_goal,fault_paused;
    reg turn_mission;
    reg [1:0] recovery_attempts;
    reg [8:0] recovery_ticks;
    reg signed [31:0] retreat_x,retreat_y;
    wire signed [31:0] retreat_dx=pose_x-retreat_x,retreat_dy=pose_y-retreat_y;
    wire retreat_done=retreat_dx>=100 || retreat_dx<=-100 || retreat_dy>=100 || retreat_dy<=-100;
    wire [15:0] retreat_counts=recovery_counts==0 ? 16'd1 : recovery_counts>3 ? 16'd3 : recovery_counts;
    assign recovery_speed=16'sd0;
    wire signed [31:0] grid_x=(pose_x+32'sd4096)>>>6;
    wire signed [31:0] grid_y=(pose_y+32'sd4096)>>>6;
    wire signed [31:0] goal_grid_x=(final_x+32'sd4096)>>>6;
    wire signed [31:0] goal_grid_y=(final_y+32'sd4096)>>>6;
    wire coordinates_inside=pose_x>=-4096 && pose_x<4096 && pose_y>=-4096 && pose_y<4096 &&
        final_x>=-4096 && final_x<4096 && final_y>=-4096 && final_y<4096;
    // The centred64x64 planning lattice cannot represent fine index127.
    // Invalid goals stay visibly parked until a replacement GO or STOP.
    wire user_goal_inside=user_goal_x>=-4096 && user_goal_x<4032 &&
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
