Vera-loves-program/acg720-vision-robot/(commit log)

2026-10-01 Diagnose DDR startup stall and document Aliyun Python setup
2026-10-01 Document rollback to preserved working camera bitstream
2026-10-01 Fix PLL control handoff and pipeline camera UI and UDP integration
2026-10-02 Rewrite Ethernet guide for Vera WSL setup and record camera recovery
2026-10-03 Document Orange Pi migration and sensor integration plan
2026-10-03 Add clean dataset bursts and staged GT911 visual interaction UI
2026-10-03 Add FPGA dataset capture and staged GT911 visual interaction
    Publish owned FPGA sources, host tools and guides. Preserve local vendor IP and working R2 camera project; add an independent R3 touch UI. Dataset photos and generated outputs are excluded.
2026-10-03 Fix capture byte-order detection and expand WSL dataset guide
    [capture_dataset.py, udp_probe.py, udp_video_viewer.py, video_stream.py]
2026-10-03 Fix LCD pinch zoom and separate R4 dashboard cards
    [gt911_touch.v, lcd1024_interaction_ui.v, lcd_camera_zoom.v, package_orangepi_client.py, render_lcd_ui_preview.py, test_vision_interaction.py, touch_gestures.v, udp_video_viewer.py]
2026-10-04 Clarify routed campus SSH checks for current WiFi addresses
2026-10-04 Record successful FPGA probe and targeted DNS repair
2026-10-04 Document unstable hotspot diagnosis and existing wired fallback
2026-10-04 Explain hotspot troubleshooting and temporary wired diagnostics
2026-10-04 Fix GTK viewer and capture premature window exit
    [capture_dataset.py, highgui_window.py, package_orangepi_client.py, udp_video_viewer.py]
2026-10-04 docs: verify sensor interfaces, pin budget, battery monitoring and vision assets
2026-10-04 docs: plan sensor wiring, dual battery monitoring and vision integration
2026-10-04 docs: revise expansion board buses, BQ grounding and motor protection
2026-10-05 docs: share sensor I2C using confirmed TOF SHUT and IMU SA0 pins
2026-10-05 Add temporary IMU ultrasonic and bidirectional Bluetooth demo
2026-10-05 Capture ultrasonic echo throughout trigger and align seller timing
2026-10-05 Record ultrasonic loopback result and pending UART command diagnosis
2026-10-05 Record working ultrasonic measurements and Bluetooth ping telemetry
2026-10-05 Add RTC seven-segment clock and unit-bearing sensor display
2026-10-07 Document BQ34Z100-G1 pin connections and grounding options
2026-10-07 Add annotated BQ34Z100-G1 3S schematic reference
2026-10-07 docs: verify ACG720 power rails and BQ supply boundaries
2026-10-07 docs: simplify BQ34Z100 interface to direct I2C
2026-10-07 docs: unify BQ ground net names and capacitor assembly
2026-10-07 docs: clarify battery shunt and system return wiring
2026-10-07 Clarify main buck grounding and XL4005 schematic corrections
2026-10-07 Document main slide switch wiring with battery gauges
2026-10-07 Explain unused switch contact and capacitor discharge
2026-10-07 Review complete adapter schematic and record required corrections
2026-10-07 Verify revised P7 assignment against board schematic and current CST
2026-10-08 Audit fabrication schematic and netlist, record sensor and BQ I2C wiring
2026-10-08 Add dual motor PID control and LCD tuning for fabricated P7 map
